QuartzAl/LoRaWAN-Aquaponics-Sensor/Enclosure box.FCStd

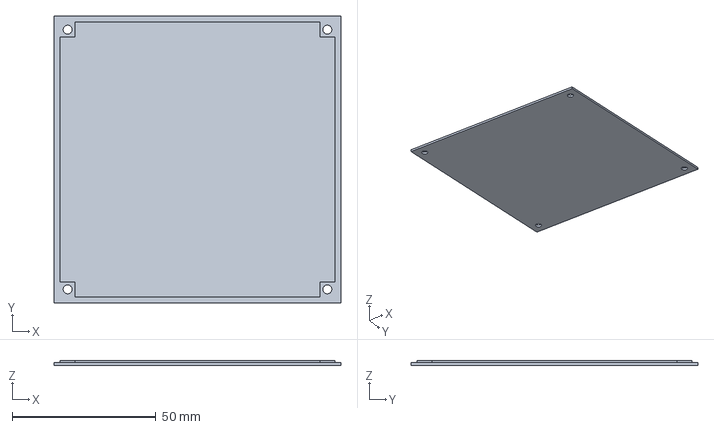
[picture p1: CAD file, 2025-11-13]
Enclosure box.FCStd
100.0 x 100.0 x 1.75 mm
