QuartzAl/LoRaWAN-Aquaponics-Sensor/Enclosure box - V2.stl

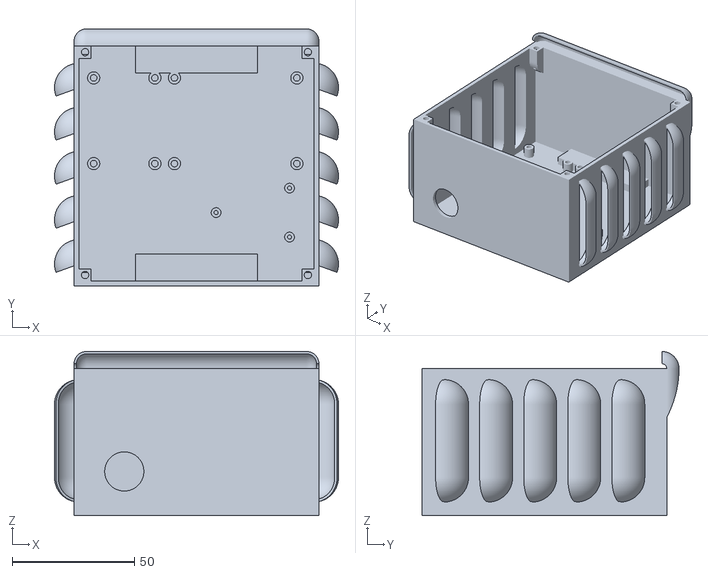
[picture p2: CAD file, 2025-11-13]
Enclosure box - V2.stl
116.0 x 105.0 x 67.0
