QuartzAl/LoRaWAN-Aquaponics-Sensor/(list of files, cad)

Other CAD files:
Enclosure box LID - V2.stl
