QuartzAl/LoRaWAN-Aquaponics-Sensor/(commit log)

2025-08-12 gas web calibration, thermistor support
2025-08-13 adjusted thermistor temperature calculation
2025-08-13 changed web to enable thermistor for calculation or not
2025-08-14 display interval and battery sensing
2025-08-21 add DHT and mains power detection support
2025-09-16 added logic for reconnecting and resolved dependencies
    [main.cpp]
2025-11-13 Added designed enclosure box
    [Enclosure box - V2.stl, Enclosure box LID - V2.stl, Enclosure box.FCStd]
